Skyr/fiber-wristband/docs/4-preview.jpg

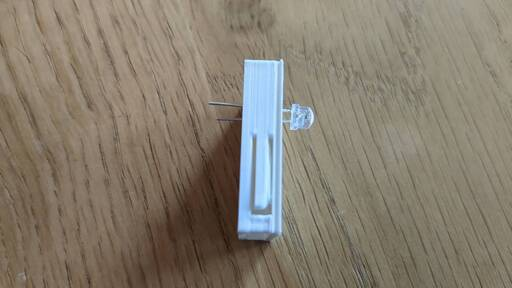
docs/4-preview.jpg
