Skyr/fiber-wristband/(commit log)

2023-07-20 First draft
    [fiber-wristband.scad]
2023-07-20 Increase bridge distance. Add cables
    [fiber-wristband.scad]
2023-07-20 Bendable walls thicker; increase diam for pins (were closed in print)
    [fiber-wristband.scad]
2023-07-20 A bit more room for pin on ground; move other pin further from border
    [fiber-wristband.scad]
2023-07-27 Prepare new outer dimensions. Move holes.
    [fiber-wristband.scad]
2023-07-27 Overlapping opening for clipping+sliding
    [fiber-wristband.scad]
2023-07-28 Thinner walls
    [fiber-wristband.scad]
2023-07-28 Variables for tuning clip
    [fiber-wristband.scad]
2023-08-18 Suchschlagworte für Material
